Tamakichi/Arduino_USBToPS2/(commit log)

2016-11-18 バージョン2スケッチ
2016-11-20 ドキュメント更新
2016-11-20 ドキュメント用画像追加
2016-11-21 「その他」を追記
2016-11-21 接続例写真ミス訂正
2016-11-22 PS/2端子の割り当ての記載について追記
2016-11-22 制約事項にキーリーピートについて追記
2016-11-23 KBD2、KBD2のピン割り付け記載ミスの訂正
2016-11-24 改行忘れの修正
2016-12-02 マウス非対応に修正、setup時の時間待ち削除
2016-12-14 ライブラリps2dev要２ヶ所修正の追記
2016-12-14 ライブラリps2devは２ヶ所の修正が必要となります. を追加
2016-12-14 ライブラリps2devは２ヶ所の修正が必要となります.を追記
2016-12-17 メディアキーについての説明に追記
2016-12-17 マウス利用の記述訂正（消し線）
2017-04-22 IchigoLatteの起動直後のPS/2バス不安定の対応
